FaysalAriss/cleaning-tracker/Enclosure/README.md

The files in this directory are the enclosure CAD files, used for 3D printing. They should be in the right orientation and have the proper color. Everything was printed on a Bambu A1 with AMS.

If you wish to modify the CAD file then make a copy: https://cad.onshape.com/documents/98f97b5cd436fa80f085599f/w/e138575f0552b6b029fff384/e/e5f88fe84230ef011079ceda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
