FaysalAriss/cleaning-tracker/docs/README.md

This is where additional documentation lives

`./assets` contains media for the docs

`./daily-journal` contains the daily notes I make while working on this project

`general.md` Tidbits that I picked up along the way which are relevant to remember while working on this project

`backlog.md` Tasks that should be done in the future. Usually a small task I remember needs to be done but can't get to in the day or I'm not at that stage yet but don't want to forget doing the task.

`reference.md` Stuff I've learnt that I think would be useful to reference in the future, like `general.md` but not necesarilly related to this project.
