FaysalAriss/cleaning-tracker/docs/daily-journal/manual-markdown-notes/driver-specific-block-diagram.png

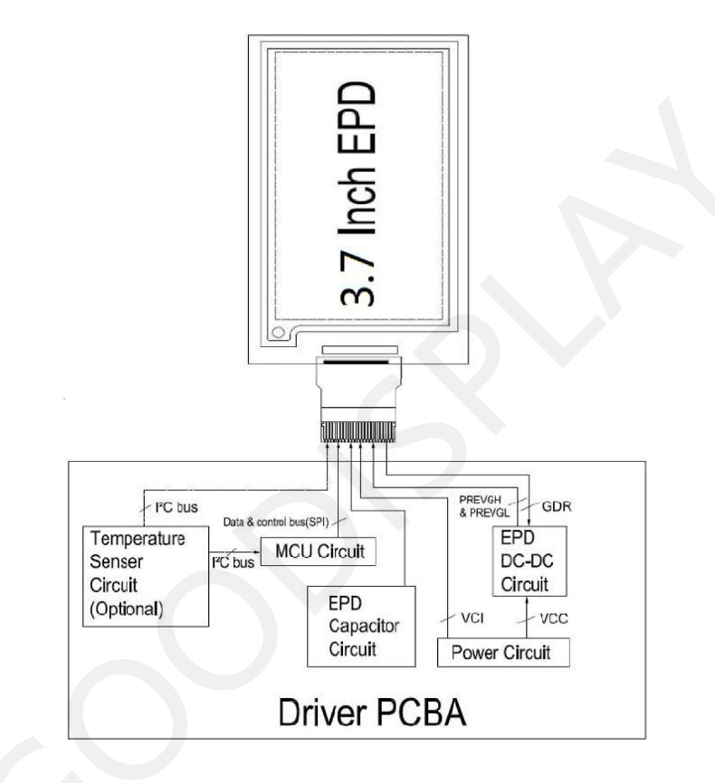
docs/daily-journal/manual-markdown-notes/driver-specific-block-diagram.png
