FaysalAriss/cleaning-tracker/PCB/BOM_Main_PCB1_2026-04-08.csv

No. | Quantity | Comment | Designator | Footprint | Value | Manufacturer Part | Supplier Part | Note
1 | 1 | CR2032 | BT1 | BAT-TH_BS-02-A1AJ010 |  | BS-02-A1AJ010 | C5239862 | battery holder
4 | 6 | 100nF | C2,C3,C4,C5,C6,C8 | C0402 | 100nF |  |  | 402
10 | 1 | EPD | FPC1 | FPC-SMD_24P-P0.50_FPC-05FB-24PH20 |  | FPC-05FB-24PH20 | C2856831 | double sided fpc
16 | 1 | 1M | R13 | R0603 | 1M |  |  | ±1%
18 | 3 | 1k | R15,R17,Rxt | R0603 | 1k |  |  | standard
