FaysalAriss/cleaning-tracker/PCB/Eink-BOM.csv

Quantity | Comment | Designator | Footprint | Value | Manufacturer Part | Supplier Part | Note
3 | AAA | BT2 | BAT-SMD_BH-AAA-B5AA001 |  | BH-AAA-B5AA001 | C964881
3 | EPD | FPC1 | FPC-SMD_P0.50-24P_QCHF-SM-H2.0 |  | AFC24-S24FIA-00 | C262683 | Check if you have (Double sided)
5 | SI1308EDL | Q1 | SOT-323_L2.0-W1.3-P1.30-LS2.1-BR |  | SI1308EDL-T1-GE3 | C469327
50 | 1M | R13 | R0603 | 1M |  | C49653530 | ±1%, check if you have
50 | 0.47 | R14 | R0603 | 0.47 |  | C103895 | ±1%, check if you have
4 | RTC | U2 | OSC-SMD_8P-L3.2-W1.5-P0.90-BL |  | RV-3028-C7-32.768kHz-1ppm-TA-QC | C3019759
2 | FOR REFLOW OVEN | U11 | TO-92-3_L4.9-W3.7-P1.27-L |  | DS18B20+ | C9753
3 | STM32U073CCT6 | U13 | LFQFP-48_L7.0-W7.0-P0.50-LS9.0-BL |  | STM32U073CCT6 | C22391359
5 | 10uH | U16 | IND-SMD_L3.0-W3.0 | 10uH | YHNR3015-100M | C7433099
