FaysalAriss/cleaning-tracker/components/README.md

The folders in this directory contain files related to the components (includes datasheets, design guides, manufacturer provided code)

Components are grouped by category so there might be multiple per folder
