FaysalAriss/cleaning-tracker/Enclosure/Case main color V1.0.3mf

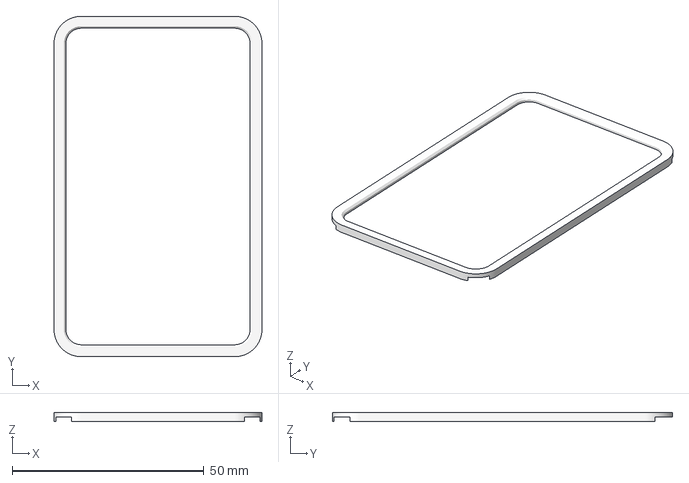
[picture p5: CAD file, 2026-05-01]
Enclosure/Case main color V1.0.3mf
54.2 x 88.7 x 2.30 mm
