FaysalAriss/cleaning-tracker/Enclosure/Case main V2.2.3mf

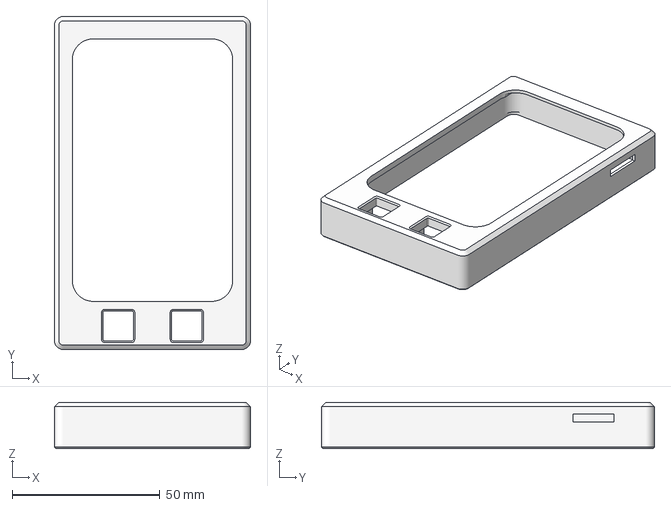
[picture p6: CAD file, 2026-05-01]
Enclosure/Case main V2.2.3mf
66.3 x 112.6 x 15.7 mm
