FaysalAriss/cleaning-tracker/PCB/Board_outline_AutoCAD2018.dxf

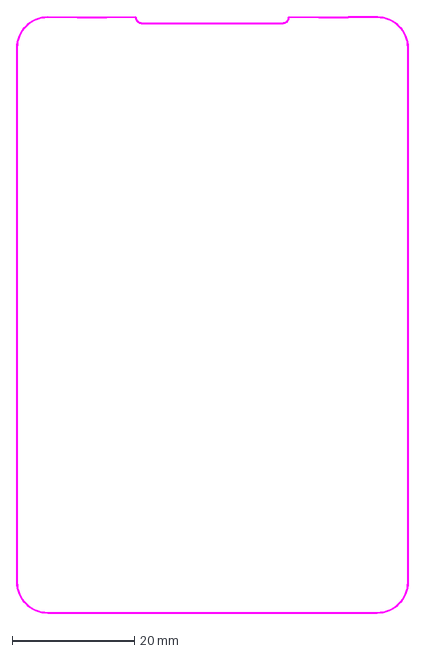
[picture p7: CAD file, 2026-05-01]
PCB/Board_outline_AutoCAD2018.dxf
64.2 x 97.7 mm
