FaysalAriss/cleaning-tracker/PCB/Multi-layer_AutoCAD2018.dxf

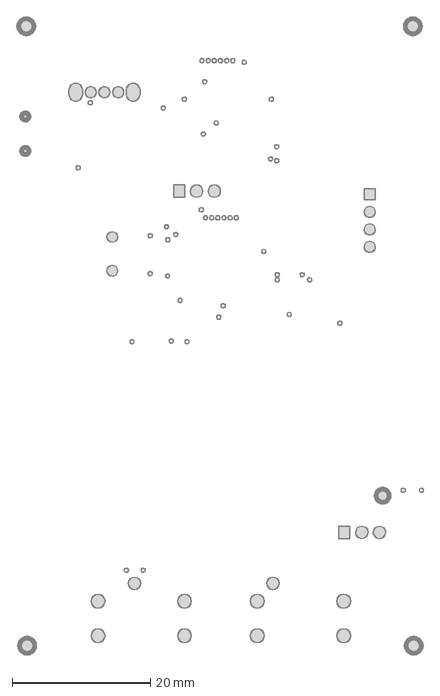
[picture p8: CAD file, 2026-05-01]
PCB/Multi-layer_AutoCAD2018.dxf
58.9 x 92.4 mm
