FaysalAriss/cleaning-tracker/Enclosure/Eink-bottom-spacer.3mf

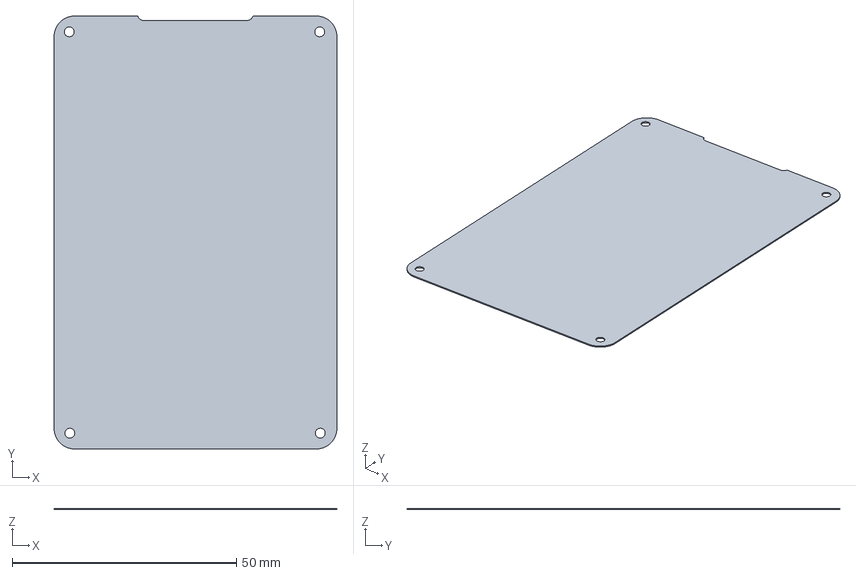
[picture p9: CAD file, 2026-05-01]
Enclosure/Eink-bottom-spacer.3mf
63.1 x 96.6 x 0.3 mm
