FaysalAriss/cleaning-tracker/Enclosure/Spacer V1.1.3mf

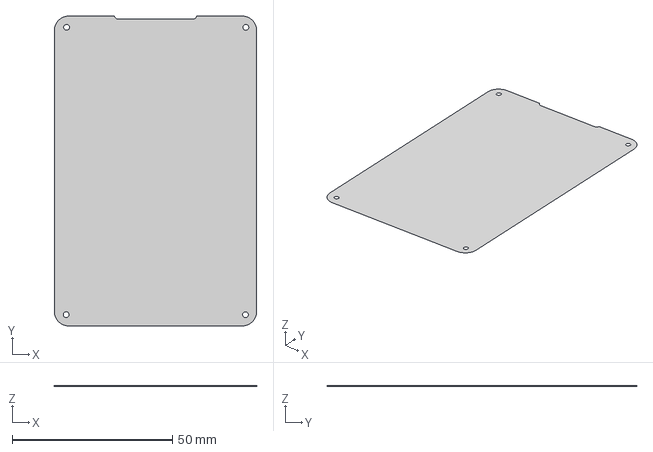
[picture p10: CAD file, 2026-05-01]
Enclosure/Spacer V1.1.3mf
63.1 x 96.6 x 0.1 mm
