FaysalAriss/cleaning-tracker/Enclosure/Case main V2.0.3mf

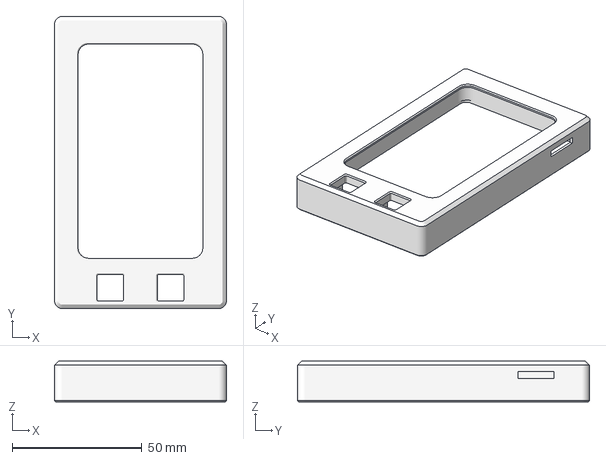
[picture p11: CAD file, 2026-05-01, an earlier design]
Enclosure/Case main V2.0.3mf
66.3 x 112.6 x 15.7 mm
