FaysalAriss/cleaning-tracker/Enclosure/Case main V1.0.3mf

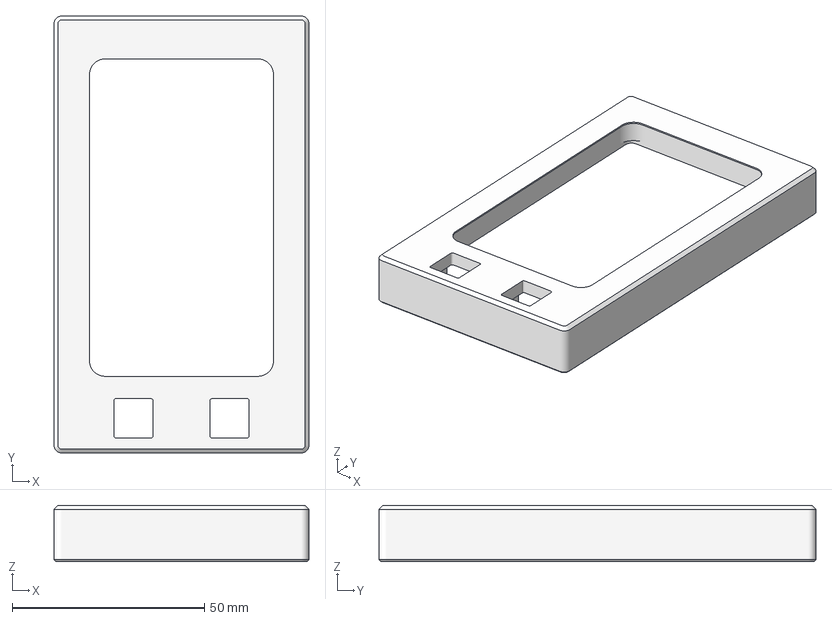
[picture p12: CAD file, 2026-05-01, an earlier design]
Enclosure/Case main V1.0.3mf
66.3 x 113.7 x 14.6 mm
