FaysalAriss/cleaning-tracker/(list of files, cad)

Other CAD files:
Enclosure/Case main V2.1.3mf
