FaysalAriss/cleaning-tracker/docs/daily-journal/manual-markdown-notes/03-10.md

Exporting BOM, double checking things. And ordering components.
