FaysalAriss/cleaning-tracker/docs/daily-journal/manual-markdown-notes/waystogofurther.md

i2c:
- use interrupt or dma mode for i2c
- make my own interrupt service routine for i2c
- make my own i2c library where i control the bits
- learn all the details of i2c: clock stretching...

spi:
- use dma
- make my own spi library
- learn all the details of spi

additions:
- add leds
- add speaker with confetti chime
- use an rtc that needs an external oscillator
- unique way to check off that you're done. simulating paper rip?
- add battery (with charging)

case:
- design a case to be CNCed out of translucent plastic (made by me or order online)
