FaysalAriss/cleaning-tracker/docs/daily-journal/manual-markdown-notes/02-18.md

the eink displays in the size i want seem to all be using SPI
there are some using I2C but they don't use pixels, its segments with select things you can display

researching lots of mcus and figuring out if they have an rtc and their accuracy didn't seem like the best use of my time so i asked gemini to get an idea and it seems using an external crystal with an in built rtc has a drift of 1.7s/day which is ok but will add up and id rather not calibrate this thing from time to time. also i would like to deal with multiple communication protocols so i think using an external rtc will be my best choice.

for a non rechargeable battery it seems i don't need a battery management system (bms).

so then my requirements for the mcu are as follows:
- stm32
- i2c bus
- spi bus
- 2-3 gpio for buttons
- low power capabilities
- ideally is able to run on a standard battery (non lipo)

to find it i looked for a mcu selector for stm32

https://www.st.com/content/st_com/en/stm32-mcu-product-selector.html

this one was overwhelming and i thought there was a better way to find it

https://www.st.com/en/microcontrollers-microprocessors/stm32-32-bit-arm-cortex-mcus.html

this one had what i wanted right away with the ultra lower power ones. but i still had to see if it fit the other requirements and what other options there were since they have 1500 mcus and there are certaintly more than 7 low power ones. also it marked coremark as a benchmark so i had to see what that meant. it seems to just be used as their custom benchmark and used to compare their chips. i will mostly look at the frequency but it should matter much for me as i can load every possible image i need to print onto the screen in the buffer then push it when need it. so it can be slow to make the image.

after digging around and filtering it seems the l0 or u0 line is ideal. they all support at least one spi and one i2c bus (on different pins). the u0 line draws a miniscule amount of power on standby. but has higher frequency so draws more power during operation unless i can simply lower it. there are still lots of options within that so i will hold off on finalizing until ive made a prototype. that way i can see how much flash i need and whatever else i encounter and need from doing the prototype.

it seems a cr2032 should be suitable for my application and last longer than the shelf life of the battery. however that can also be decided later after my measure the power draw from the prototype.
