FaysalAriss/cleaning-tracker/docs/daily-journal/manual-markdown-notes/2-25.md

With a basic UI drawn I can move on to connecting the RTC to this new board along with the screen. I2C1 uses pb6 and pb7, I still had to configure the interrupt pin, to keep them close I used pb5. This warned me that there is map conflict. Looking at the datasheet pb5 can be used as smba for i2c1, so then I checked and that mode was unable to used. I didn't need it but had to know. Had some weird errors, remember to not add ';' in #define.

I did:
```
HAL_StatusTypeDef RTC_set_register_pointer(I2C_HandleTypeDef *hi2c, uint8_t register_number){
  return HAL_I2C_Master_Transmit(hi2c, DS3231_ADDRESS, &register_number, 1, HAL_MAX_DELAY);
} 
```
This works because the function is blocking so we know the state of the stack won't change. register_number is stored on the stack and we are pointing to it.

I'm making "drivers" to make it easier to use the devices. I'm going to follow the layout from the existing drivers I see like HAL. I will keep the docs in the .c files. I learned about the mem write/read HAL functions which send the first register and then read/write.

RTC works, blinks when alarm goes off.

The screen also works.

Time for new components: buttons.
