FaysalAriss/cleaning-tracker/docs/daily-journal/notes-logseq/journals/2026_04_09.md

- Opened PCB
- Put paste using stencil
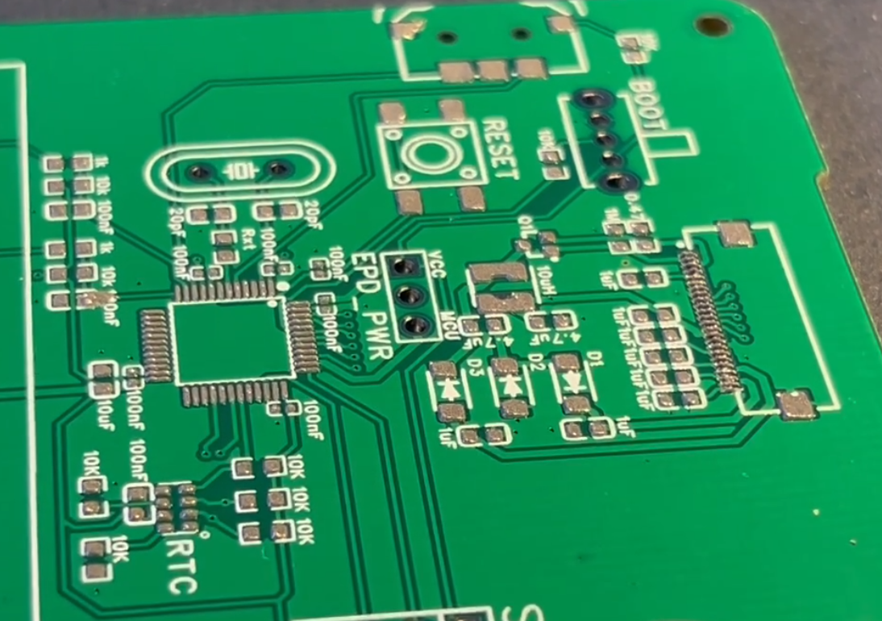
[picture p99: docs/daily-journal/notes-logseq/assets/image_1785304678955_0.png]
	- 
- Put components on
	- Made sure to put diodes in right way same with MCU
	- MCU came vacuum sealed with humidity meter
	- Checked if some components will melt (FPC connector, button, switch)
		- FPC shows good for reflow, others dont mention
		- FPC says 85C for ambient but good for reflow the others either dont mention or say similar ambient. I will try
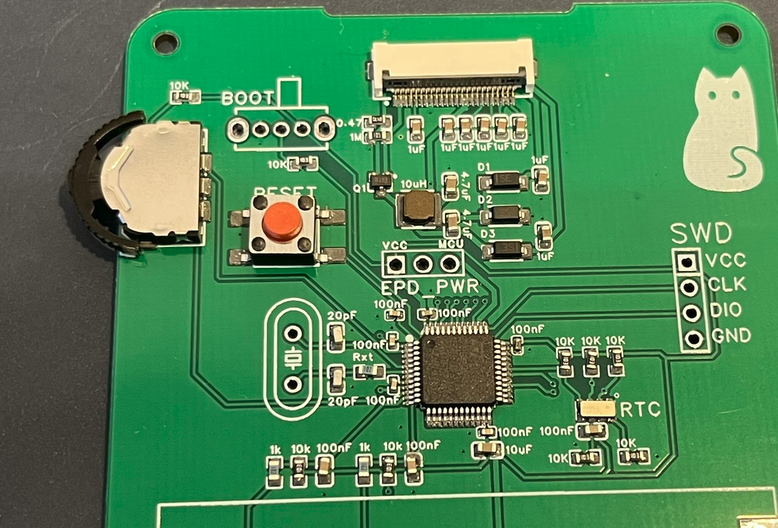
[picture p100: docs/daily-journal/notes-logseq/assets/image_1785304793227_0.png]
	- 
- Used reflow oven
