FaysalAriss/cleaning-tracker/docs/daily-journal/notes-logseq/journals/2026_04_10.md

- Soldered header pins for SWD
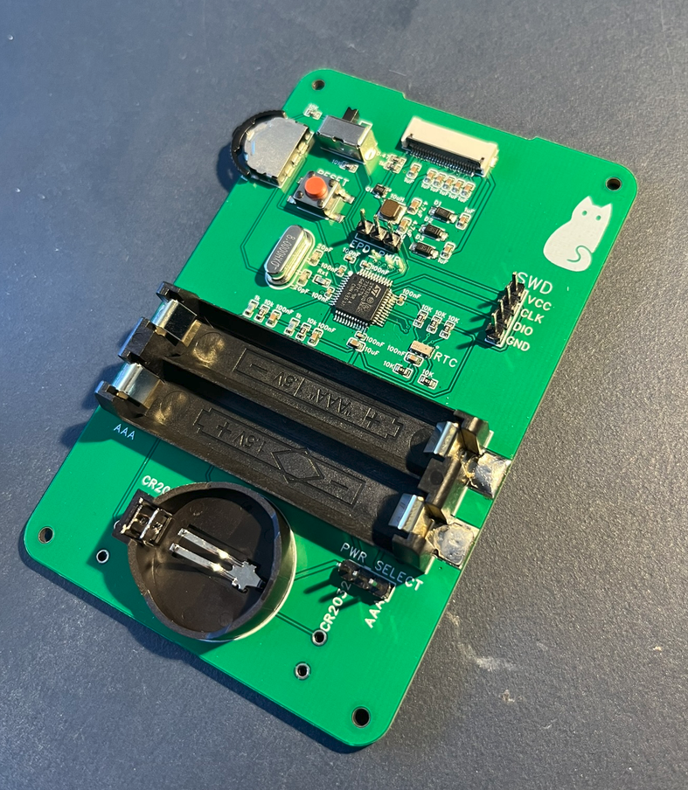
[picture p101: docs/daily-journal/notes-logseq/assets/image_1785357183260_0.png]
	- 
- Flashed dummy code, flashes!
- Will first test communication with RTC then external clock
	- Found RTC address from datasheet. As learned before making LSB 0
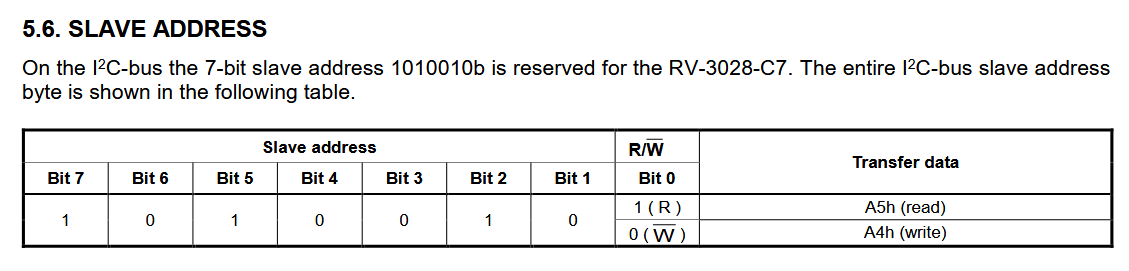
[picture p102: docs/daily-journal/notes-logseq/assets/rtc_address_1775869635744_0.png]
	- 
	- The operation is the same as the other, there is a register pointer that I can change or continue reading from, which will increment by one at each read or write
	- I will just read the seconds every second
	- ```
	    #define RTC_ADDRESS 0b10100100
	    uint8_t data[5];
	    for(int i = 0; i<5; i++){
	    	  HAL_I2C_Mem_Read(&hi2c1, RTC_ADDRESS, 0x00, I2C_MEMADD_SIZE_8BIT, data+i, 1, HAL_MAX_DELAY);
	    	  HAL_Delay(1000);
	    }
	  ```
	- I read 5 seconds in a row. The output:
	- ```ascii
	  101000
	  101001
	  110000
	  110001
	  110010
	  ```
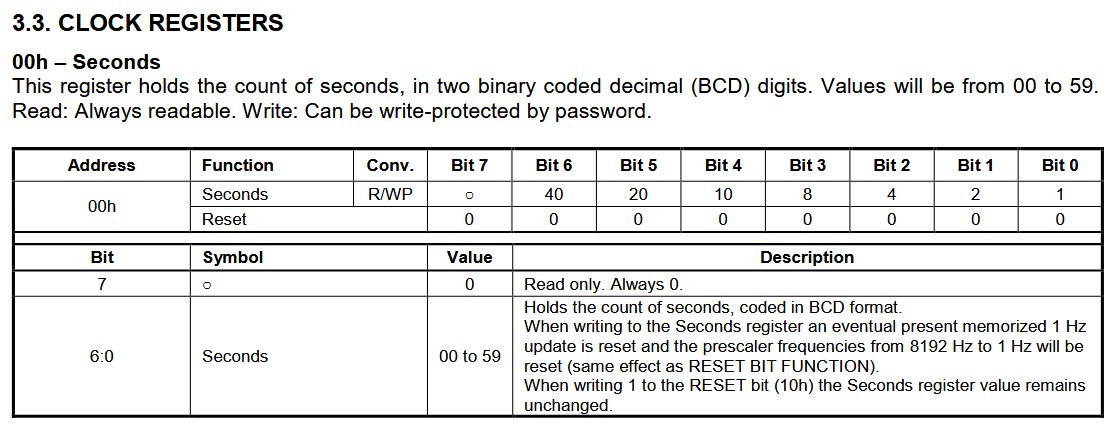
[picture p103: docs/daily-journal/notes-logseq/assets/rtc_seconds_BCD_1775870786233_0.png]
	- 
	- Given their format this good. It goes 28, 29, 30, 31, 32
	- Great. RTC works and I can communicate with it. I need to set up the alarm interrupt
- I will now try to use the external clock with the same code
	- I set the system clock to use the external high speed clock (HSE) and told it its at 8Mhz. I already enabled crystal/ceramic oscillator option in the RCC (reset and clock control) section so it would allow me to make this selection
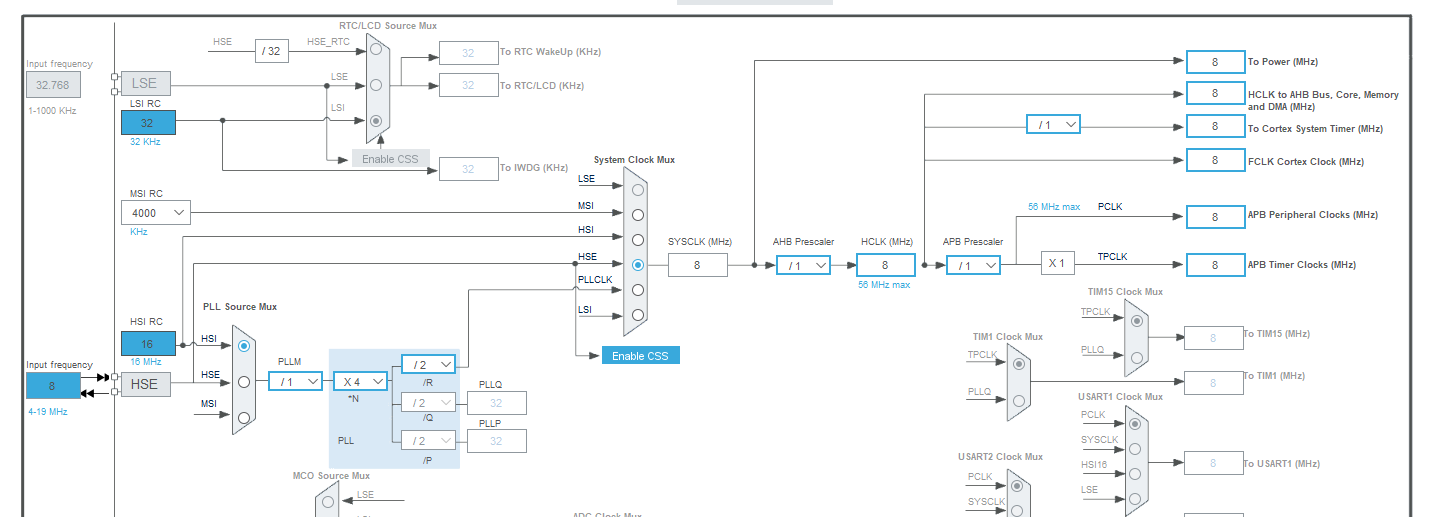
[picture p104: docs/daily-journal/notes-logseq/assets/u0_external_clock_setup_init_1775871081527_0.png]
	- 
	- I will just check the value of the external resistor again as I currently have it set to 1K and that might be too high
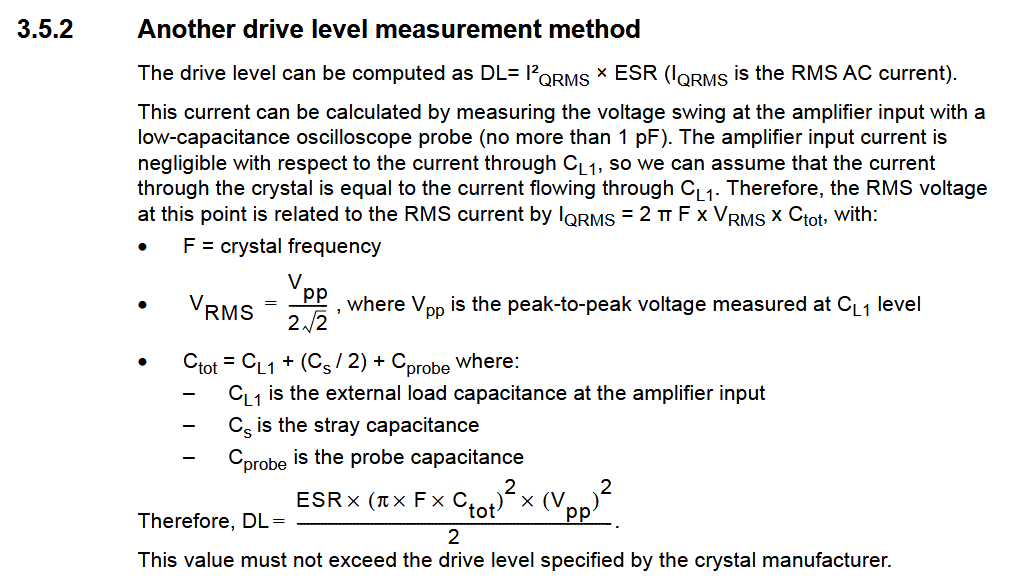
[picture p105: docs/daily-journal/notes-logseq/assets/capacitor_calculation_oscillator_1775872431036_0.png]
	- 
		- i get ((1/2)\*(60)*(pi\*8000000\*(21.5\*10^-12))^2\*(3.3)^2)\*10^6 = 95.4 uW
		- by using 8mhz. 20 pF CL1, 3pF Cs, no probe, 60 ohm ESR (from datasheet for 7-10mHz) and 3.3V drive voltage
		- this is about the 100uW ideal drive level and well under the 500uW max. Im not sure how I did my previous calculation. Its also possible I used a different datasheet because this pack of crystals is unlabelled. But looking at more datasheets they have very similar values
		- I will replace the 1K with a 0 ohm before flashing
	- It's now that I wish I had put on leds or broken out uart as i'm not sure how to test if the hse is working
		- online they recommend to check the HSERDY bit
		- from the U0 reference manual "The HSERDY flag in the Clock control register (RCC_CR) indicates if the HSE oscillator is stable or not". With 1 indicating ready and 0 not
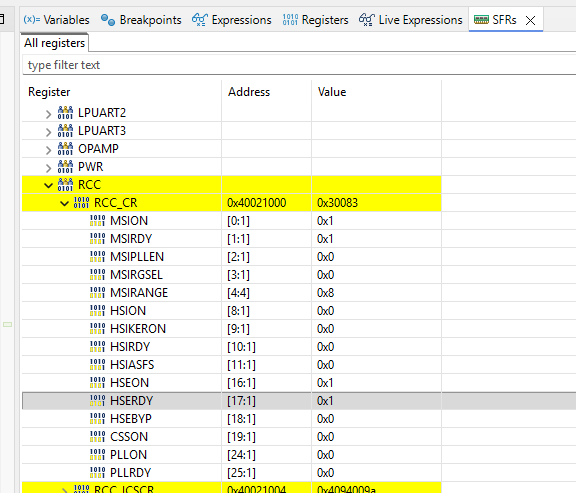
[picture p106: docs/daily-journal/notes-logseq/assets/hserdy_HSE_1775873599295_0.png]
		- 
		- works!!!
- Next big thing is the eink
