FaysalAriss/cleaning-tracker/docs/daily-journal/notes-logseq/journals/2026_04_18.md

- Time to redesign this john
- Remodelled, almost good need more space for the screen and need to fix the color. The screw holes seem to always need to be drilled out
- Made a few iterations. Looks good now
- Printed with variable layer height, used adaptive then smooth to be able to get to 0.1 resolution like 8.9 prints 8.91 instead of 8.8
- I used standoffs I had on hand as they had female and male screws and they worked perfect
- Soldered on the buttons by using wires as extension
- I printed the back and assembled. It looks great. Now just need to code
