FaysalAriss/cleaning-tracker/docs/daily-journal/notes-logseq/journals/2026_04_08.md

- PCB arrived
- (double) Checking BOM if i have everything on hand
