FaysalAriss/cleaning-tracker/docs/daily-journal/notes-logseq/journals/2026_04_11.md

- I will test the eink. I will use a jumper to use 3.3V for the power instead of the power pin like I did in the earlier test
- I will adapt the code I already adapted but now for this chip
	- I think I forgot to use a source folder when testing the new eink which is why I had issues with the path, because im comparing when I made a "My Drivers" folder in another project and for the new eink project
	- Which is as easy as changing the include to the right library f4 -> u0.h. And changing to the appropriate pin names. Changing some includes to a better path as ive fixed the source folder issue. And changing SPI to GPIO for bit banging
	- I will flash before connecting EPD just in case magic smoke comes out.
	- I will also check voltages. PreVGL and PreVGH to be exact, should've made test pads for those.
		- I just get 3.3V and 0V even when pressing reset, I checked on the driver board and it does the same. I think I just need to connect the screen
	- It works! And the reset button works as well
	- Also I might've not noted this down yet but the PCB is too short in height, the eink connector bends nicely around but it takes up almost the whole height so the keys can be on the board, they are easy to solder to though and I can just hold them in the case
