FaysalAriss/cleaning-tracker/daily-journal/README.md

Started with manual markdown notes so they contain notes until 03-16

Logseq notes are from then to present

The image backups are there as I didn't realize logseq kept its own copy
