FaysalAriss/cleaning-tracker/docs/daily-journal/notes-logseq/assets/image_1774054394164_0.png

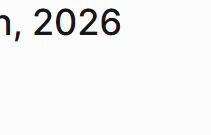
docs/daily-journal/notes-logseq/assets/image_1774054394164_0.png
