FaysalAriss/cleaning-tracker/docs/daily-journal/notes-logseq/assets/image_1785304766690_0.png

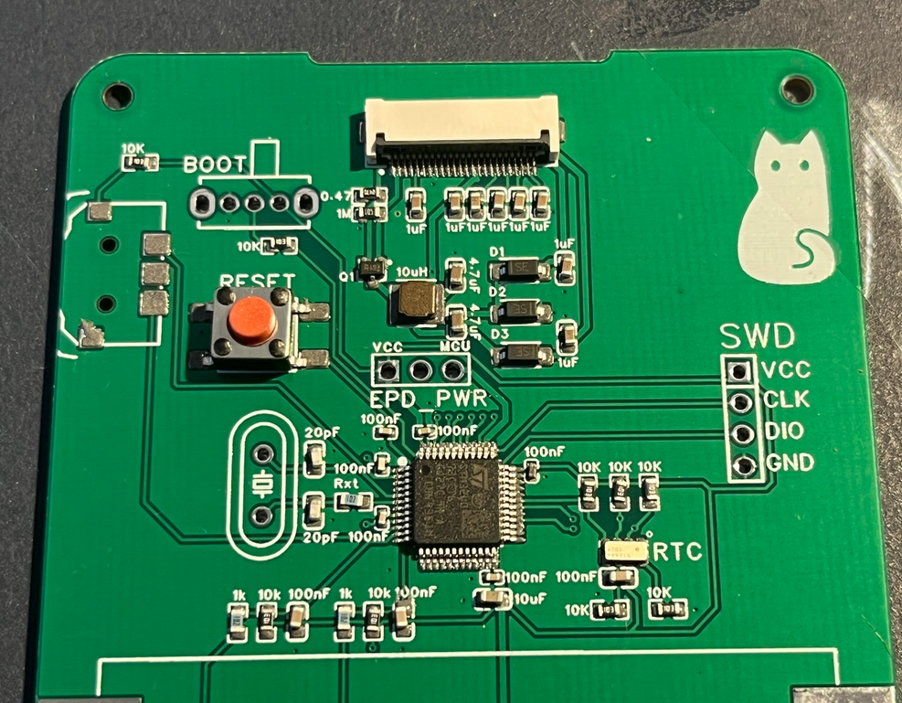
docs/daily-journal/notes-logseq/assets/image_1785304766690_0.png
