FaysalAriss/cleaning-tracker/docs/daily-journal/notes-logseq/assets/image_1786507936123_0.png

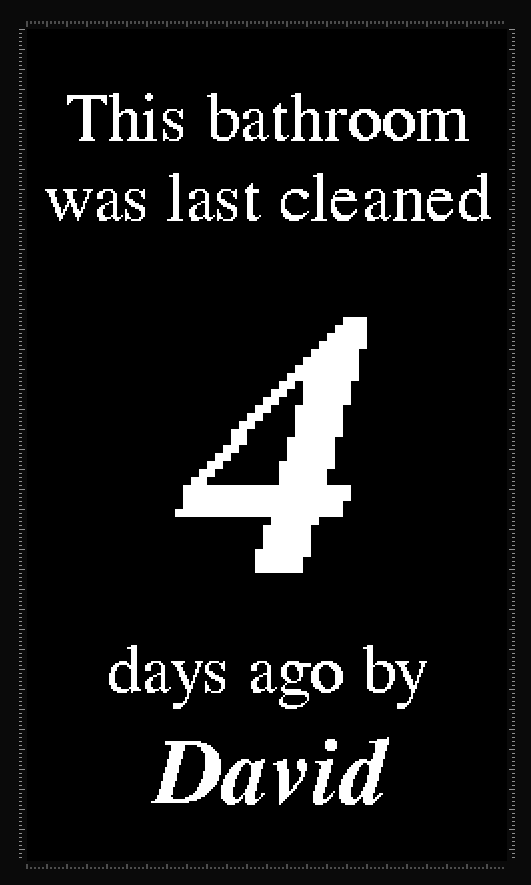
docs/daily-journal/notes-logseq/assets/image_1786507936123_0.png
