FaysalAriss/cleaning-tracker/docs/daily-journal/notes-logseq/assets/image_1787268108960_0.png

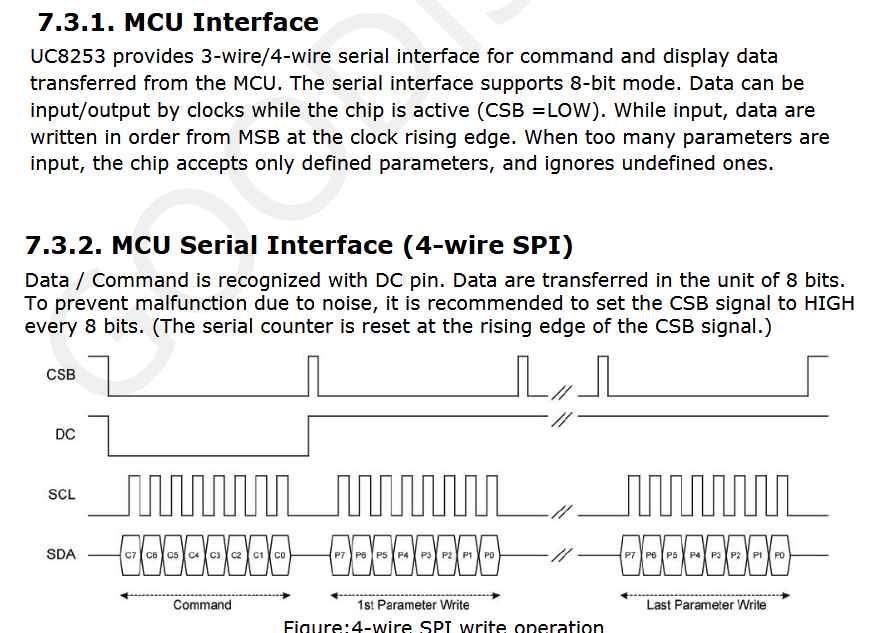
docs/daily-journal/notes-logseq/assets/image_1787268108960_0.png
