FaysalAriss/cleaning-tracker/components/stm/nucleo72rb-pinout-searchable.pdf

Hardware layout and configuration | UM1724

# Figure 11. NUCLEO-F072RB

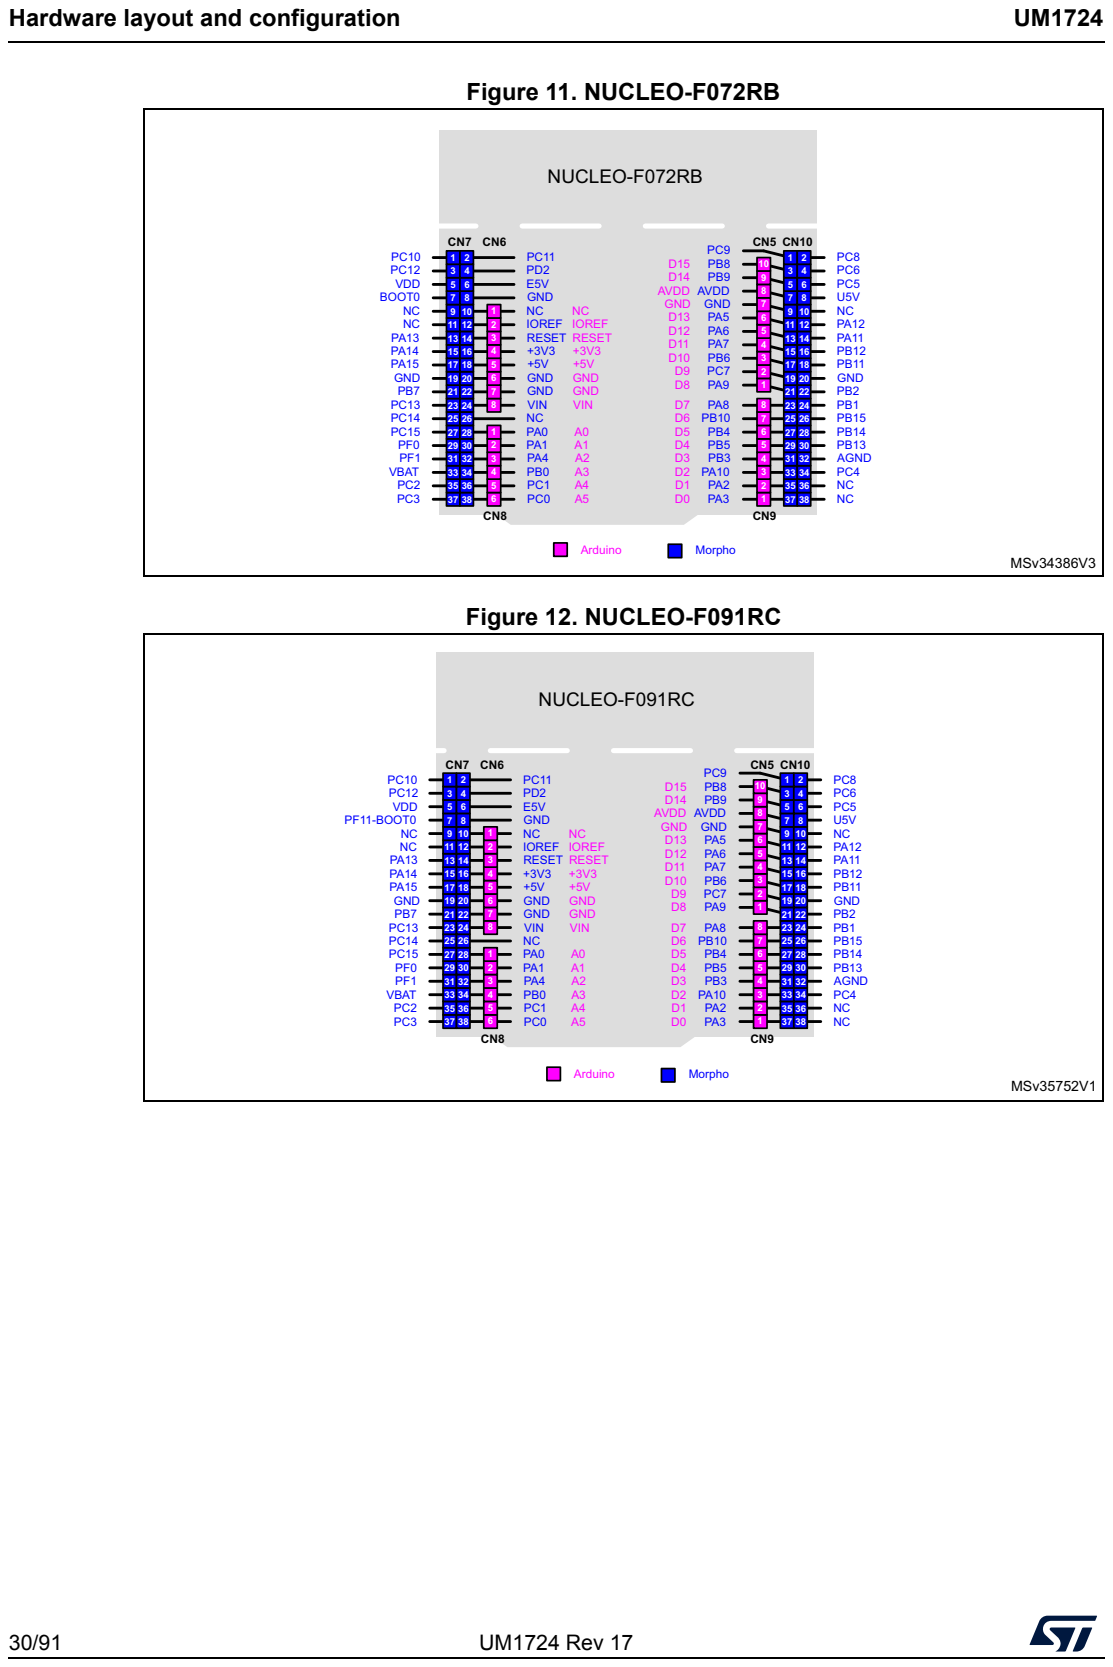
[picture p131: page 1]
