FaysalAriss/cleaning-tracker/Projects/u0-EPD/Src/main.c

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
/* Includes ------------------------------------------------------------------*/
#include "main.h"

/* USER CODE BEGIN Includes */
//EPD
#include "Ap_29demo.h"
#include "Display_EPD_W21.h"
#include "Display_EPD_W21_spi.h"
#include "fonts.h"
#include "GUI_Paint.h"

#if 1
   unsigned char BlackImage[EPD_ARRAY];//Define canvas space
#endif
//Tips//
/*
1.Flickering is normal when EPD is performing a full screen update to clear ghosting from the previous image so to ensure better clarity and legibility for the new image.
2.There will be no flicker when EPD performs a partial refresh.
3.Please make sue that EPD enters sleep mode when update is completed and always leave the sleep mode command. Otherwise, this may result in a reduced lifespan of EPD.
4.Please refrain from inserting EPD to the FPC socket or unplugging it when the MCU is being powered to prevent potential damage.)
5.Re-initialization is required for every full screen update.
6.When porting the program, set the BUSY pin to input mode and other pins to output mode.
*/
/* USER CODE END Includes */


void SystemClock_Config(void);
static void MX_GPIO_Init(void);
/**
  * @brief  The application entry point.
  * @retval int
  */
int main(void)
{

  /* MCU Configuration--------------------------------------------------------*/

  /* Reset of all peripherals, Initializes the Flash interface and the Systick. */
  HAL_Init();

  /* Configure the system clock */
  SystemClock_Config();

  /* Initialize all configured peripherals */
  MX_GPIO_Init();
  /* USER CODE BEGIN 2 */

#if 1
	//Full screen refresh, fast refresh, and partial update demostration.
	EPD_Init(); //Full screen update initialization.
	EPD_WhiteScreen_White(); //Clear screen function.
	EPD_DeepSleep(); //Enter the sleep mode and please do not delete it, otherwise it will reduce the lifespan of the screen.
	HAL_Delay(2000); //Delay for 2s.

//	EPD_Init_Black_Border(); //Full screen update initialization.
//	EPD_WhiteScreen_White(); //Clear screen function.
//	EPD_DeepSleep(); //Enter the sleep mode and please do not delete it, otherwise it will reduce the lifespan of the screen.
//	HAL_Delay(8000); //Delay for 2s.

//	/************Full display(2s)*******************/
//	EPD_Init(); //Full screen updateinitialization.
//	EPD_WhiteScreen_ALL(gImage_1); //To Display one image using full screen refresh.
//	EPD_DeepSleep(); //Enter the sleep mode and please do not delete it, otherwise it will reduce the lifespan of the screen.
//	HAL_Delay(2000); //Delay for 2s.
//
//	/************Fast updatemode(1.5s)*******************/
	EPD_Init_Fast(); //Fast updateinitialization.
	EPD_WhiteScreen_ALL(gImage_2); //To display one image using fast refresh.
	EPD_DeepSleep(); //Enter the sleep mode and please do not delete it, otherwise it will reduce the lifespan of the screen.
	HAL_Delay(2000); //Delay for 2s.

	//	/************4 Gray updatemode*******************/
//	EPD_Init_4G(); //Fast updateinitialization.
//	EPD_WhiteScreen_ALL_4G(gImage_4G1); //To display one image using fast refresh.
//	HAL_Delay(5000);
//	EPD_WhiteScreen_ALL_4G(gImage_4G1);
//	HAL_Delay(5000);
//	EPD_WhiteScreen_ALL_4G(gImage_4G1);
//	HAL_Delay(5000);
//	EPD_WhiteScreen_ALL_4G(gImage_4G1);
//	EPD_DeepSleep(); //Enter the sleep mode and please do not delete it, otherwise it will reduce the lifespan of the screen.
//	HAL_Delay(2000); //Delay for 2s.

	#if 1
		//Partial updatedemostration.
		//Partial updatedemo support displaying a clock at 5 locations with 00:00.  If you need to perform partial updatemore than 5 locations, please use the feature of using partial updateat the full screen demo.
		//After 5 partial refreshes, implement a full screen updateto clear the ghosting caused by partial refreshes.
		//////////////////////Partial updatetime demo/////////////////////////////////////
		EPD_Init(); //Electronic paper initialization.
		EPD_SetRAMValue_BaseMap(gImage_basemap); //Please do not delete the background color function, otherwise it will cause unstable display during partial refresh.
		for(int i=0;i<6;i++)
		{
		  EPD_Dis_Part_Time(100,120,Num[1],Num[0],gImage_numdot,Num[0],Num[i],5,32,64); //x,y,DATA-A~E,number,Resolution 32*64
		}
		EPD_DeepSleep();  //Enter the sleep mode and please do not delete it, otherwise it will reduce the lifespan of the screen.
		HAL_Delay(2000);	//Delay for 2s.
		EPD_Init(); //Full screen updateinitialization.
		EPD_WhiteScreen_White(); //Clear screen function.
		EPD_DeepSleep(); //Enter the sleep mode and please do not delete it, otherwise it will reduce the lifespan of the screen.
		HAL_Delay(2000); //Delay for 2s.
	#endif

	#if 0
		//Demo of using partial updateto update the full screen, to enable this feature, please change 0 to 1.
		//After 5 partial refreshes, implement a full screen updateto clear the ghosting caused by partial refreshes.
		//////////////////////Partial updatetime demo/////////////////////////////////////
		EPD_Init(); //Full screen updateinitialization.
		EPD_WhiteScreen_White(); //Clear screen function.
		EPD_Dis_PartAll(gImage_p1);
		EPD_Dis_PartAll(gImage_p2);
		EPD_Dis_PartAll(gImage_p3);
		EPD_DeepSleep();//Enter the sleep mode and please do not delete it, otherwise it will reduce the lifespan of the screen.
		HAL_Delay(2000); //Delay for 2s.

		EPD_Init(); //Full screen updateinitialization.
		EPD_WhiteScreen_White(); //Clear screen function.
		EPD_DeepSleep(); //Enter the sleep mode and please do not delete it, otherwise it will reduce the lifespan of the screen.
		HAL_Delay(2000);	//Delay for 2s.
	#endif

	#if 0
		//Demonstration of full screen updatewith 180-degree rotation, to enable this feature, please change 0 to 1.
		/************Full display(2s)*******************/
		EPD_Init_180(); //Full screen updateinitialization.
		EPD_WhiteScreen_ALL(gImage_p1); //To Display one image using full screen refresh.
		EPD_DeepSleep(); //Enter the sleep mode and please do not delete it, otherwise it will reduce the lifespan of the screen.
		HAL_Delay(2000); //Delay for 2s.
	#endif

#endif

  /* USER CODE END 2 */

  /* Infinite loop */
  /* USER CODE BEGIN WHILE */
  while (1)
  {
    /* USER CODE END WHILE */

    /* USER CODE BEGIN 3 */
  }
  /* USER CODE END 3 */
}

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
