FaysalAriss/cleaning-tracker/u0-main-v1/u0-main-v1.ioc

Mcu.UserName=STM32U073CCTx
PA0.GPIO_Label=SW_RIGHT
PA0.Signal=PWR_WKUP1
PA1.GPIO_Label=BTN1_WKUP
PA1.Signal=PWR_WKUP3
PA10.GPIO_Label=RTC_SDA
PA10.Signal=I2C1_SDA
PA15.GPIO_Label=EPD_PWR
PA15.Signal=GPIO_Output
PA2.GPIO_Label=BTN2_WKUP
PA2.Signal=PWR_WKUP4
PA9.GPIO_Label=RTC_SCL
PA9.Signal=I2C1_SCL
PB15.GPIO_Label=RTC_WKUP
PB15.Signal=PWR_WKUP7
PB3.GPIO_Label=EPD_SCK
PB3.Signal=GPIO_Output
PB5.GPIO_Label=EPD_SDA
PB5.Signal=GPIO_Output
PB6.GPIO_Label=EPD_CS
PB6.Signal=GPIO_Output
PB7.GPIO_Label=EPD_DC
PB7.Signal=GPIO_Output
PB8.GPIO_Label=EPD_RST
PB8.Signal=GPIO_Output
PB9.GPIO_Label=EPD_BUSY
PB9.Signal=GPIO_Input
PC13.GPIO_Label=SW_LEFT
PC13.Signal=PWR_WKUP2
PF0-OSC_IN.Signal=RCC_OSC_IN
PF1-OSC_OUT.Signal=RCC_OSC_OUT
