FaysalAriss/cleaning-tracker/Projects/u0-EPD/MyDrivers/EPD/EPD/Display_EPD_W21.c

#include "../../EPD/EPD/Display_EPD_W21.h"

#include "../../EPD/EPD/Display_EPD_W21_spi.h"

unsigned char oldData[12480];
unsigned char oldDataP[256];
unsigned char oldDataA[256];
unsigned char oldDataB[256];
unsigned char oldDataC[256];
unsigned char oldDataD[256];
unsigned char oldDataE[256];
unsigned char partFlag=1;
void delay_xms(unsigned int xms)
{
//	unsigned int i;
//	while(xms--)
//	{
//		i=12000;
//		while(i--);
//	}
	HAL_Delay(xms);
}



void lcd_chkstatus(void)
{
	while(!isEPD_W21_BUSY); //0:BUSY, 1:FREE
                     
}

//UC8253
void EPD_Init(void)
{	
	EPD_W21_RST_0;		// Module reset
	delay_xms(10);//At least 10ms delay 
	EPD_W21_RST_1;
	delay_xms(10);//At least 10ms delay 
	
	EPD_W21_WriteCMD(0x04);  //Power on
	lcd_chkstatus();        //waiting for the electronic paper IC to release the idle signal

	EPD_W21_WriteCMD(0X50);  //VCOM AND DATA INTERVAL SETTING			
	EPD_W21_WriteDATA(0x97); //WBmode:VBDF 17|D7 VBDW 97 VBDB 57		WBRmode:VBDF F7 VBDW 77 VBDB 37  VBDR B7	
}

//UC8253
void EPD_Init_Black_Border(void)
{
	EPD_W21_RST_0;		// Module reset
	delay_xms(10);//At least 10ms delay
	EPD_W21_RST_1;
	delay_xms(10);//At least 10ms delay

	EPD_W21_WriteCMD(0x04);  //Power on
	lcd_chkstatus();        //waiting for the electronic paper IC to release the idle signal

	EPD_W21_WriteCMD(0X50);  //VCOM AND DATA INTERVAL SETTING
	EPD_W21_WriteDATA(0x57); //WBmode:VBDF 17|D7 VBDW 97 VBDB 57		WBRmode:VBDF F7 VBDW 77 VBDB 37  VBDR B7
}

void EPD_Init_Fast(void) //1.5s
{	
	EPD_W21_RST_0;		// Module reset
	delay_xms(10);//At least 10ms delay 
	EPD_W21_RST_1;
	delay_xms(10);//At least 10ms delay 
	
  EPD_W21_WriteCMD(0x04);  //Power on
	lcd_chkstatus();        //waiting for the electronic paper IC to release the idle signal

	EPD_W21_WriteCMD(0xE0);
	EPD_W21_WriteDATA(0x02); 

	EPD_W21_WriteCMD(0xE5);
	EPD_W21_WriteDATA(0x5F);  //0x5F--1.5s

}	

void EPD_Init_Part(void)
{	
	EPD_W21_RST_0;		// Module reset
	delay_xms(10);//At least 10ms delay 
	EPD_W21_RST_1;
	delay_xms(10);//At least 10ms delay 
		
  EPD_W21_WriteCMD(0x04);  //Power on
	lcd_chkstatus();        //waiting for the electronic paper IC to release the idle signal

	EPD_W21_WriteCMD(0xE0);
	EPD_W21_WriteDATA(0x02); 

	EPD_W21_WriteCMD(0xE5);
	EPD_W21_WriteDATA(0x6E);
		
	EPD_W21_WriteCMD(0x50); 
	EPD_W21_WriteDATA(0xD7); 
	
}	
void EPD_Init_4G(void) //
{	
	EPD_W21_RST_0;		// Module reset
	delay_xms(10);//At least 10ms delay 
	EPD_W21_RST_1;
	delay_xms(10);//At least 10ms delay 

	EPD_W21_WriteCMD(0x00);
	EPD_W21_WriteDATA(0x1F);
	
  EPD_W21_WriteCMD(0x04);  //Power on
	lcd_chkstatus();        //waiting for the electronic paper IC to release the idle signal

	EPD_W21_WriteCMD(0xE0);
	EPD_W21_WriteDATA(0x02); 

	EPD_W21_WriteCMD(0xE5);
	EPD_W21_WriteDATA(0x5A);  //0x5A--4 Gray
	
}	
void EPD_DeepSleep(void)
{
	EPD_W21_WriteCMD(0X02);  	//power off
	lcd_chkstatus();          //waiting for the electronic paper IC to release the idle signal
	EPD_W21_WriteCMD(0X07);  	//deep sleep
	EPD_W21_WriteDATA(0xA5); 
	
}
void Power_off(void)
{	
	EPD_W21_WriteCMD(0x02); //POWER off
	lcd_chkstatus();
}
//Full screen updateupdate function
void EPD_Update(void)
{   
	//Refresh
	EPD_W21_WriteCMD(0x12);		//DISPLAY update	
	delay_xms(1);	             //!!!The delay here is necessary, 200uS at least!!!     
	lcd_chkstatus();          //waiting for the electronic paper IC to release the idle signal
}
void EPD_WhiteScreen_ALL(const unsigned char *datas)
{
    unsigned int i;
	  //Write Data
		EPD_W21_WriteCMD(0x10);	       //Transfer old data
	  for(i=0;i<EPD_ARRAY;i++)	  
    {	
			 EPD_W21_WriteDATA(oldData[i]);  //Transfer the actual displayed data
    }	
		EPD_W21_WriteCMD(0x13);		     //Transfer new data
	  for(i=0;i<EPD_ARRAY;i++)	     
	  {
	    EPD_W21_WriteDATA(datas[i]);  //Transfer the actual displayed data
       oldData[i]=datas[i]; 
	  }		
    EPD_Update();	   
		Power_off();
}

//Clear screen display
void EPD_WhiteScreen_White(void)
{
		unsigned int i;
		//Write Data
		EPD_W21_WriteCMD(0x10);	     
		for(i=0;i<EPD_ARRAY;i++)	     
		{
			EPD_W21_WriteDATA(oldData[i]);  
		}
		EPD_W21_WriteCMD(0x13);	     
		for(i=0;i<EPD_ARRAY;i++)	     
		{
			EPD_W21_WriteDATA(0xff);  
			oldData[i]=0xff; 
		}
    EPD_Update();	   
		Power_off();
}
//Display all black
void EPD_WhiteScreen_Black(void)
{
		unsigned int i;
		//Write Data
		EPD_W21_WriteCMD(0x10);	     
		for(i=0;i<EPD_ARRAY;i++)	     
		{
			EPD_W21_WriteDATA(oldData[i]);  
		}
		EPD_W21_WriteCMD(0x13);	     
		for(i=0;i<EPD_ARRAY;i++)	     
		{
			EPD_W21_WriteDATA(0x00);  
			oldData[i]=0x00; 
		}
    EPD_Update();	   
		Power_off();
}
//Partial updateof background display, this function is necessary, please do not delete it!!!
void EPD_SetRAMValue_BaseMap( const unsigned char * datas)
{
  unsigned int i;	
  EPD_W21_WriteCMD(0x10);  //write old data 
  for(i=0;i<EPD_ARRAY;i++)
   {               
     EPD_W21_WriteDATA(oldData[i]);
   }
  EPD_W21_WriteCMD(0x13);  //write new data 
  for(i=0;i<EPD_ARRAY;i++)
   {               
     EPD_W21_WriteDATA(datas[i]);
		  oldData[i]=datas[i]; 
   }	 
    EPD_Update();	   
		Power_off();	 
	 
}
void EPD_Dis_Part(unsigned int x_start,unsigned int y_start,const unsigned char * datas,unsigned int PART_COLUMN,unsigned int PART_LINE)
{
unsigned int i;
unsigned int x_end,y_end;	
	x_start=x_start-x_start%8;
	x_end=x_start+PART_LINE-1; 
  y_end=y_start+PART_COLUMN-1;

	  EPD_Init_Part();	
	
	  EPD_W21_WriteCMD(0x91);		//This command makes the display enter partial mode
		EPD_W21_WriteCMD(0x90);		//resolution setting
		EPD_W21_WriteDATA (x_start);   //x-start     
		EPD_W21_WriteDATA (x_end);	 //x-end	

		EPD_W21_WriteDATA (y_start/256);
		EPD_W21_WriteDATA (y_start%256);   //y-start    
		
		EPD_W21_WriteDATA (y_end/256);		
		EPD_W21_WriteDATA (y_end%256);  //y-end
		EPD_W21_WriteDATA (0x01);	
 
		if(partFlag==1) 
		 {
			 	partFlag=0;
			 
			 	EPD_W21_WriteCMD(0x10);	       //writes Old data to SRAM for programming
			  for(i=0;i<PART_COLUMN*PART_LINE/8;i++)      
				   EPD_W21_WriteDATA(0xFF); 
		 }
		else
		 {
			 	EPD_W21_WriteCMD(0x10);	       //writes Old data to SRAM for programming
			  for(i=0;i<PART_COLUMN*PART_LINE/8;i++)      
				   EPD_W21_WriteDATA(oldDataP[i]);  
			} 
 
		EPD_W21_WriteCMD(0x13);				 //writes New data to SRAM.
		for(i=0;i<PART_COLUMN*PART_LINE/8;i++)	     
	 {
		EPD_W21_WriteDATA(datas[i]);
    oldDataP[i]=datas[i];
	 } 
    EPD_Update();    
		Power_off();	
	  
}


//Full screen partial updatedisplay
void EPD_Dis_PartAll(const unsigned char * datas)
{
    unsigned int i;
	  EPD_Init_Part();
	  //Write Data
		EPD_W21_WriteCMD(0x10);	       //Transfer old data
	  for(i=0;i<EPD_ARRAY;i++)	  
    {	
			 EPD_W21_WriteDATA(oldData[i]);  //Transfer the actual displayed data
    }	
		EPD_W21_WriteCMD(0x13);		     //Transfer new data
	  for(i=0;i<EPD_ARRAY;i++)	     
	  {
	    EPD_W21_WriteDATA(datas[i]);  //Transfer the actual displayed data
       oldData[i]=datas[i]; 
	  }  
			
    EPD_Update();	   
		Power_off();	  

}

//Partial updatewrite address and data
void EPD_Dis_Part_RAM(unsigned int x_start,unsigned int y_start,
	                      const unsigned char * datas_A,const unsigned char * datas_B,
												const unsigned char * datas_C,const unsigned char * datas_D,const unsigned char * datas_E,
                        unsigned char num,unsigned int PART_COLUMN,unsigned int PART_LINE)
{
	unsigned int i,x_end,y_end;
	x_start=x_start-x_start%8;
	x_end=x_start+PART_LINE-1; 
  y_end=y_start+PART_COLUMN*num-1;

	  EPD_Init_Part();	
	  EPD_W21_WriteCMD(0x91);		//This command makes the display enter partial mode
		EPD_W21_WriteCMD(0x90);		//resolution setting
		EPD_W21_WriteDATA (x_start);   //x-start     
		EPD_W21_WriteDATA (x_end);	 //x-end	

		EPD_W21_WriteDATA (y_start/256);
		EPD_W21_WriteDATA (y_start%256);   //y-start    
		
		EPD_W21_WriteDATA (y_end/256);		
		EPD_W21_WriteDATA (y_end%256);  //y-end
		EPD_W21_WriteDATA (0x01);	


	if(partFlag==1) 
	 {
			partFlag=0;
		 
			EPD_W21_WriteCMD(0x10);	       //writes Old data to SRAM for programming
			for(i=0;i<PART_COLUMN*PART_LINE*num/8;i++)      
				 EPD_W21_WriteDATA(0xFF); 
	 }
	else
	 {
			EPD_W21_WriteCMD(0x10);	       //writes Old data to SRAM for programming
			for(i=0;i<PART_COLUMN*PART_LINE/8;i++)	     
				EPD_W21_WriteDATA(oldDataA[i]);  						 
			for(i=0;i<PART_COLUMN*PART_LINE/8;i++)	     
				EPD_W21_WriteDATA(oldDataB[i]);  
			for(i=0;i<PART_COLUMN*PART_LINE/8;i++)	     
				EPD_W21_WriteDATA(oldDataC[i]);  						 
			for(i=0;i<PART_COLUMN*PART_LINE/8;i++)	     
				EPD_W21_WriteDATA(oldDataD[i]);
			for(i=0;i<PART_COLUMN*PART_LINE/8;i++)	     
				EPD_W21_WriteDATA(oldDataE[i]);  						 
	 
			 
		} 
 

	EPD_W21_WriteCMD(0x13);				 //writes New data to SRAM.
		{
			for(i=0;i<PART_COLUMN*PART_LINE/8;i++)	
			{			
				EPD_W21_WriteDATA(datas_A[i]);  
				oldDataA[i]=datas_A[i];
			}					
			for(i=0;i<PART_COLUMN*PART_LINE/8;i++)	
			{			
				EPD_W21_WriteDATA(datas_B[i]);  
				oldDataB[i]=datas_B[i];
			}	
			for(i=0;i<PART_COLUMN*PART_LINE/8;i++)	
			{			
				EPD_W21_WriteDATA(datas_C[i]);  
				oldDataC[i]=datas_C[i];
			}	
			for(i=0;i<PART_COLUMN*PART_LINE/8;i++)	
			{			
				EPD_W21_WriteDATA(datas_D[i]);  
				oldDataD[i]=datas_D[i];
			}	
			for(i=0;i<PART_COLUMN*PART_LINE/8;i++)	
			{			
				EPD_W21_WriteDATA(datas_E[i]);  
				oldDataE[i]=datas_E[i]; 
			}	
		}
	  
}
//Clock display
void EPD_Dis_Part_Time(unsigned int x_start,unsigned int y_start,
	                      const unsigned char * datas_A,const unsigned char * datas_B,
												const unsigned char * datas_C,const unsigned char * datas_D,const unsigned char * datas_E,
                        unsigned char num,unsigned int PART_COLUMN,unsigned int PART_LINE)
{
	EPD_Dis_Part_RAM(x_start,y_start,datas_A,datas_B,datas_C,datas_D,datas_E,num,PART_COLUMN,PART_LINE);
	EPD_Update();
	Power_off();	
}												 



////////////////////////////////Other newly added functions////////////////////////////////////////////
//Display rotation 180 degrees initialization
void EPD_Init_180(void)
{
	EPD_W21_RST_0;  // Module reset   
	delay_xms(10);//At least 10ms delay 
	EPD_W21_RST_1;
	delay_xms(10); //At least 10ms delay 
	
	EPD_W21_WriteCMD(0x00);
	EPD_W21_WriteDATA(0x1B); //180 mirror
	
	EPD_W21_WriteCMD(0x04); //POWER ON
	delay_xms(300);  
	lcd_chkstatus();
	
	EPD_W21_WriteCMD(0X50);  //VCOM AND DATA INTERVAL SETTING			
	EPD_W21_WriteDATA(0x97); //WBmode:VBDF 17|D7 VBDW 97 VBDB 57		WBRmode:VBDF F7 VBDW 77 VBDB 37  VBDR B7	
	
}

//GUI
void EPD_Init_GUI(void)
{	
	EPD_W21_RST_0;		// Module reset
	delay_xms(10);//At least 10ms delay 
	EPD_W21_RST_1;
	delay_xms(10);//At least 10ms delay 
	
	EPD_W21_WriteCMD(0x00);
	EPD_W21_WriteDATA(0x13);
	
  EPD_W21_WriteCMD(0x04);  //Power on
	lcd_chkstatus();        //waiting for the electronic paper IC to release the idle signal

	EPD_W21_WriteCMD(0X50);  //VCOM AND DATA INTERVAL SETTING			
	EPD_W21_WriteDATA(0x97); //WBmode:VBDF 17|D7 VBDW 97 VBDB 57		WBRmode:VBDF F7 VBDW 77 VBDB 37  VBDR B7	
	
}
void EPD_Display(unsigned char *Image)
{
    unsigned int Width, Height,i,j;
    Width = (EPD_WIDTH % 8 == 0)? (EPD_WIDTH / 8 ): (EPD_WIDTH / 8 + 1);
    Height = EPD_HEIGHT;

    EPD_W21_WriteCMD(0x10);
    for (j = 0; j < Height; j++) {
        for ( i = 0; i < Width; i++) {
					EPD_W21_WriteDATA(oldData[j*Width+i]);
          
        }
    }

    EPD_W21_WriteCMD(0x13);
    for ( j = 0; j < Height; j++) {
        for ( i = 0; i < Width; i++) {
           	    EPD_W21_WriteDATA(Image[j*Width+i]);  //Transfer the actual displayed data
                oldData[i]=Image[i]; 
        }
    }
		
    EPD_Update();	
}

//4 grayscale demo function
/********Color display description
      white  gray1  gray2  black
0x10|  01     01     00     00
0x13|  01     00     01     00
                                   ****************/
void EPD_WhiteScreen_ALL_4G (const unsigned char *datas)
{
	unsigned int i,j,k;
	unsigned char temp1,temp2,temp3;

	  //old  data
		EPD_W21_WriteCMD(0x10);	       

		for(i=0;i<12480;i++)	               //12480*2  416*240
		{ 
			temp3=0;
      for(j=0;j<2;j++)	
			{
				temp1 = datas[i*2+j];
				for(k=0;k<4;k++)
				{
					temp2 = temp1&0xC0 ;
					if(temp2 == 0xC0)
						temp3 |= 0x01;//white
					else if(temp2 == 0x00)
						temp3 |= 0x00;  //black
					else if(temp2 == 0x80)
						temp3 |= 0x01;  //gray1
					else if(temp2 == 0x40)
						temp3 |= 0x00; //gray2
				if(j==0)	
				{
					temp1 <<= 2;				
					temp3 <<= 1;	
				}	
        if(j==1&&k!=3)
				{
					temp1 <<= 2;				
					temp3 <<= 1;	
				}
			 }
		 }	
     EPD_W21_WriteDATA(temp3);			
		}

    //new  data
		EPD_W21_WriteCMD(0x13);	       
		for(i=0;i<12480;i++)	               //12480*2  416*240
		{ 
			temp3=0;
      for(j=0;j<2;j++)	
			{
				temp1 = datas[i*2+j];
				for(k=0;k<4;k++)
				{
					temp2 = temp1&0xC0 ;
					if(temp2 == 0xC0)
						temp3 |= 0x01;//white
					else if(temp2 == 0x00)
						temp3 |= 0x00;  //black
					else if(temp2 == 0x80)
						temp3 |= 0x00;  //gray1
					else if(temp2 == 0x40)
						temp3 |= 0x01; //gray2
       
				if(j==0)	
				{
					temp1 <<= 2;				
					temp3 <<= 1;	
				}	
        if(j==1&&k!=3)
				{
					temp1 <<= 2;				
					temp3 <<= 1;	
				}
			 }
		 }
			EPD_W21_WriteDATA(temp3);			
	 }

		//Refresh
  	EPD_W21_WriteCMD(0x12);		//DISPLAY update	
		delay_xms(1);	             //!!!The delay here is necessary, 200uS at least!!!     
		lcd_chkstatus();          //waiting for the electronic paper IC to release the idle signal
   
}

void EPD_refresh(void){
	//Refresh
	EPD_W21_WriteCMD(0x12);		//DISPLAY update
	delay_xms(1);	             //!!!The delay here is necessary, 200uS at least!!!
	lcd_chkstatus();          //waiting for the electronic paper IC to release the idle signal
}






/***********************************************************
						end file
***********************************************************/
