FaysalAriss/cleaning-tracker/(commit log)

2026-03-04 all progress since the start
    nucleo blink, uart, rtc
    black pill blink, rtc, eink, power/wakeup, prototype
    waveshare demo code
    [LCSC_BomTemplate.csv, power-calculations.xlsx]
2026-03-10 schematic + component selection done
2026-03-14 begun pcb layout
    [Eink-BOM.csv]
2026-05-02 proper shutdown + rtc interrupt handling
2026-07-24 cleaning up the structure and adding documentation
    [BOM_Main_PCB1_2026-04-08.csv, Board_outline_AutoCAD2018.dxf, Case main V1.0.3mf, Case main V2.0.3mf, Case main V2.1.3mf, Case main V2.2.3mf, Case main color V1.0.3mf, Eink-BOM.csv]
2026-08-08 Continuing trying to pinpoint RTC wakeup issue
    [RV3028.c, main.c]
2026-08-14 begining writing EPD driver
2026-08-19 EPD driver init research and beginning of writing driver
2026-08-21 MVP for EPD driver done
2026-08-21 EPD driver refresh configuration
